Traxes/dimplex-zl400-esphome/docs/bilder/gehaeuse_oben.jpg

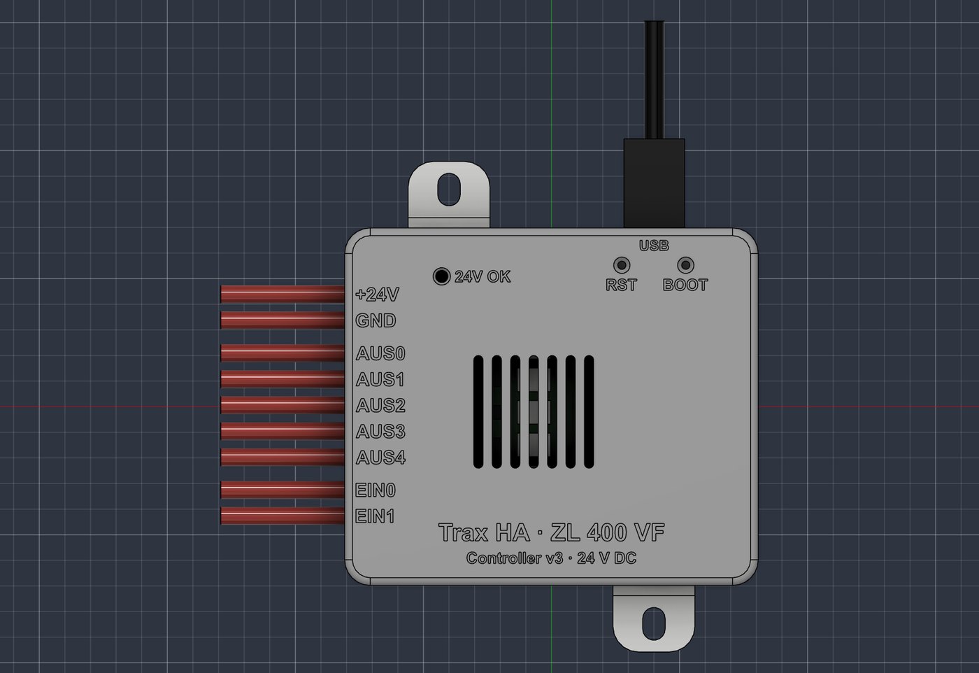
docs/bilder/gehaeuse_oben.jpg
