Traxes/dimplex-zl400-esphome/docs/bilder/massblatt_controller_v3.png

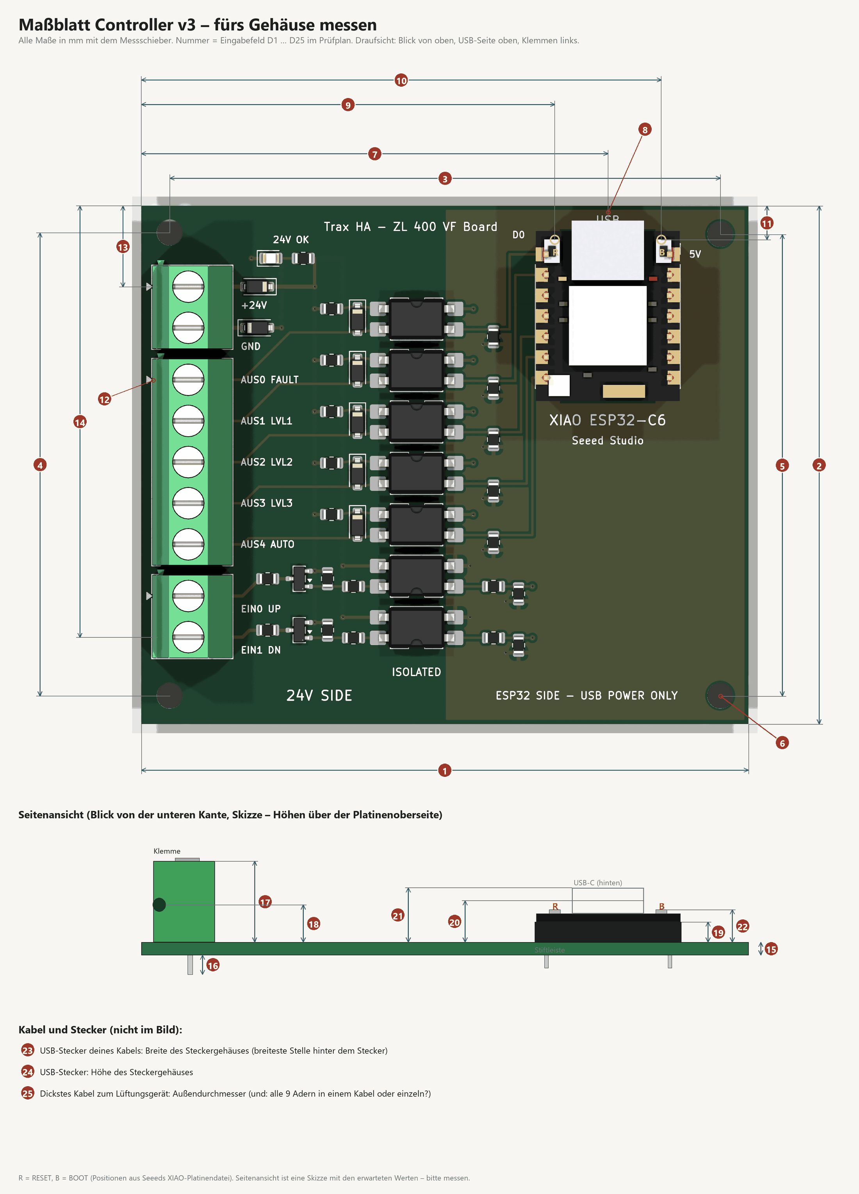
docs/bilder/massblatt_controller_v3.png
