Traxes/dimplex-zl400-esphome/hardware/controller-v3/fertigung-jlcpcb/BOM-ESP24V_HA_XIAO.csv

Comment | Designator | Footprint | LCSC Part #
1N4148W | D1,D2,D3,D4,D5,D7,D8 | Diode_SMD:D_SOD-123 | C81598
GREEN | D6 | LED_SMD:LED_0805_2012Metric | C2297
MMBT3906 | Q1,Q2 | Package_TO_SOT_SMD:SOT-23 | C2143
10k | R1,R2,R3,R4,R5,R6,R7,R8,R9,R10,R15,R16,R18,R19 | Resistor_SMD:R_0805_2012Metric | C17414
330 | R11,R12 | Resistor_SMD:R_0805_2012Metric | C17630
22k | R13,R14,R17 | Resistor_SMD:R_0805_2012Metric | C17560
1k | R20,R21 | Resistor_SMD:R_0805_2012Metric | C17513
EL817S | U1,U2,U3,U4,U5,U6,U7 | Package_DIP:SMDIP-4_W9.53mm | C63268
