Traxes/dimplex-zl400-esphome/hardware/emulator-lab-v2/fertigung-jlcpcb/BOM-ESP24V_Ventilation_LAB.csv

Comment | Designator | Footprint | LCSC Part #
GREEN | D1,D2,D3,D4,D5 | LED_SMD:LED_0805_2012Metric | C2297
RED | D6,D7 | LED_SMD:LED_0805_2012Metric | C84256
2.2k | R1,R2,R3,R4,R5 | Resistor_SMD:R_0805_2012Metric | C17520
10k | R6,R7,R8,R9,R10,R11,R12 | Resistor_SMD:R_0805_2012Metric | C17414
