Traxes/dimplex-zl400-esphome/gehaeuse/CentralVentilationCase_Baugruppe.step

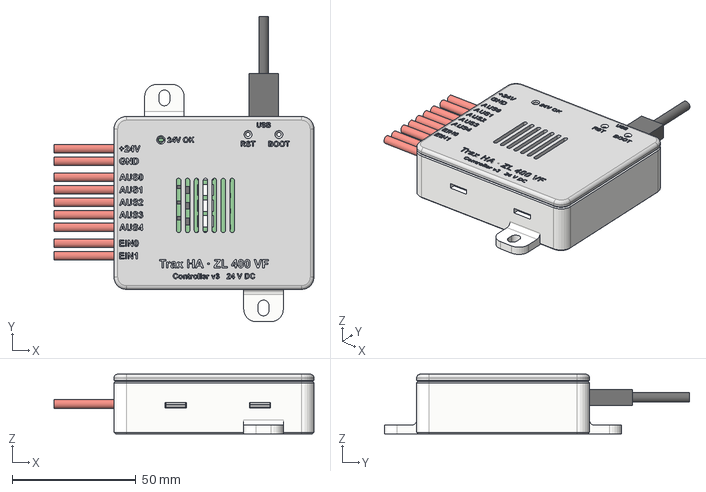
[picture p13: CAD file, 2026-10-19]
gehaeuse/CentralVentilationCase_Baugruppe.step
104.9 x 123.2 x 24.1 mm
