Traxes/dimplex-zl400-esphome/gehaeuse/CentralVentilationCase_BambuStudio_P2S_PLA.3mf

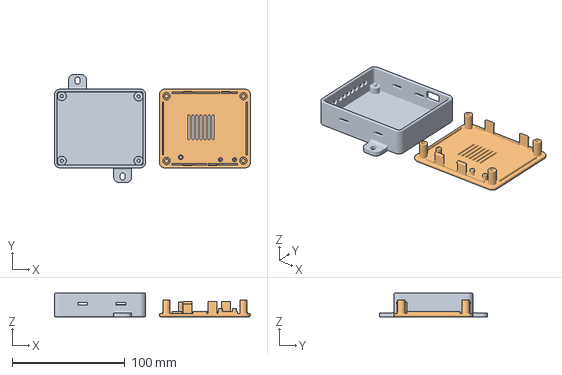
[picture p14: CAD file, 2026-10-19]
gehaeuse/CentralVentilationCase_BambuStudio_P2S_PLA.3mf
173.5 x 95.8 x 21.1 mm
Unterteil
Deckel
