Traxes/dimplex-zl400-esphome/gehaeuse/CentralVentilationCase_Deckel.stl

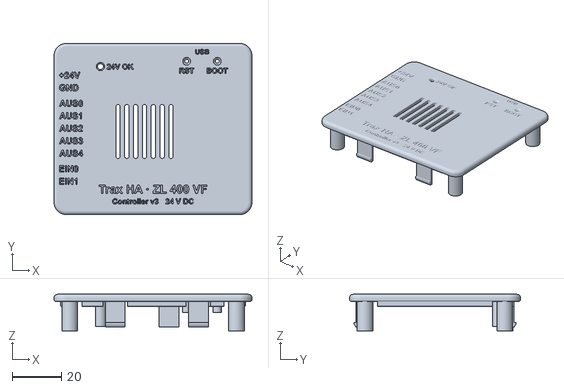
[picture p15: CAD file, 2026-10-19]
gehaeuse/CentralVentilationCase_Deckel.stl
80.7 x 69.8 x 14.9
