Traxes/dimplex-zl400-esphome/gehaeuse/CentralVentilationCase_Unterteil.stl

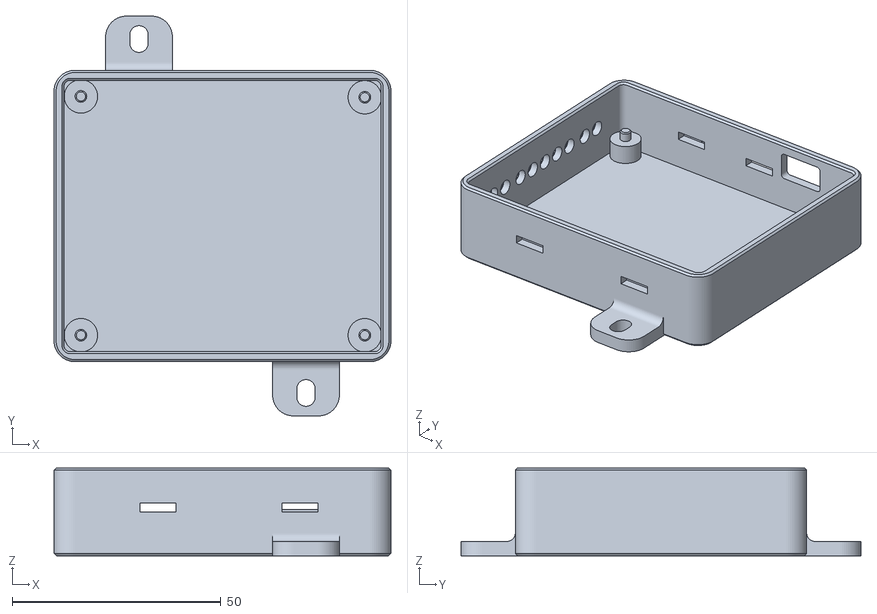
[picture p16: CAD file, 2026-10-19]
gehaeuse/CentralVentilationCase_Unterteil.stl
80.7 x 95.8 x 21.1
