Traxes/dimplex-zl400-esphome/(list of files, cad)

Other CAD files:
gehaeuse/CentralVentilationCase_Geometrie.3mf
