Traxes/dimplex-zl400-esphome/tools/verifikation/bringup_out.txt

== S0 alles aus (DIP offen, Ausgaenge LOW)
   v(rail)                   23.275 ..    23.425
   v(g24)                     0.575 ..     0.725
   I(J1) [mA]                 0.906 ..     0.919
   v(rail)-v(ina0)            0.000 ..     0.000
   v(rail)-v(ina1)            0.000 ..     0.000
   v(gp0)-v(eg)               0.001 ..     0.002
   v(gp1)-v(eg)               0.001 ..     0.002
   v(aus0)                   22.563 ..    22.935
   v(aus1)                   22.563 ..    22.935
   v(go0)-v(eg)              -0.000 ..     0.000
   v(go0)-v(oa0)             -0.000 ..     0.000
   v(ein0)                    0.990 ..     0.997
   v(rail)-v(cq0)            22.278 ..    22.435
   v(oc0)-v(g24)             22.547 ..    22.844
   v(ein1)                    0.990 ..     0.997
   v(rail)-v(bq1)             0.001 ..     0.002
   v(ol0)-v(eg)              -0.000 ..     0.000
== S1 AUS_0 aktiv + Ausgang HOCH an
   v(rail)                   23.161 ..    23.339
   v(g24)                     0.609 ..     0.770
   I(J1) [mA]                 5.583 ..     5.695
   v(rail)-v(ina0)           17.924 ..    18.281
   v(rail)-v(ina1)            0.000 ..     0.000
   v(gp0)-v(eg)               3.150 ..     3.263
   v(gp1)-v(eg)               0.001 ..     0.002
   v(aus0)                    3.921 ..     4.048
   v(aus1)                   22.453 ..    22.845
   v(go0)-v(eg)               2.971 ..     3.232
   v(go0)-v(oa0)              1.691 ..     2.096
   v(ein0)                   21.198 ..    21.395
   v(rail)-v(cq0)             0.019 ..     0.019
   v(oc0)-v(g24)              0.070 ..     0.097
   v(ein1)                    0.990 ..     0.997
   v(rail)-v(bq1)             0.001 ..     0.002
   v(ol0)-v(eg)               1.109 ..     1.312
== S2 alle 5 AUS aktiv, Ausgaenge LOW
   v(rail)                   23.122 ..    23.311
   v(g24)                     0.575 ..     0.725
   I(J1) [mA]                 9.832 ..    10.067
   v(rail)-v(ina0)           17.900 ..    18.253
   v(rail)-v(ina1)           17.900 ..    18.254
   v(gp0)-v(eg)               3.147 ..     3.263
   v(gp1)-v(eg)               3.147 ..     3.263
   v(aus0)                    3.915 ..     4.041
   v(aus1)                    3.915 ..     4.039
   v(go0)-v(eg)              -0.000 ..     0.000
   v(go0)-v(oa0)             -0.000 ..     0.000
   v(ein0)                    0.990 ..     0.996
   v(rail)-v(cq0)            22.126 ..    22.321
   v(oc0)-v(g24)             22.395 ..    22.730
   v(ein1)                    0.990 ..     0.996
   v(rail)-v(bq1)             0.001 ..     0.002
   v(ol0)-v(eg)              -0.000 ..     0.000
