Traxes/dimplex-zl400-esphome/hardware/controller-v3/Schaltplan_Controller_v3.pdf

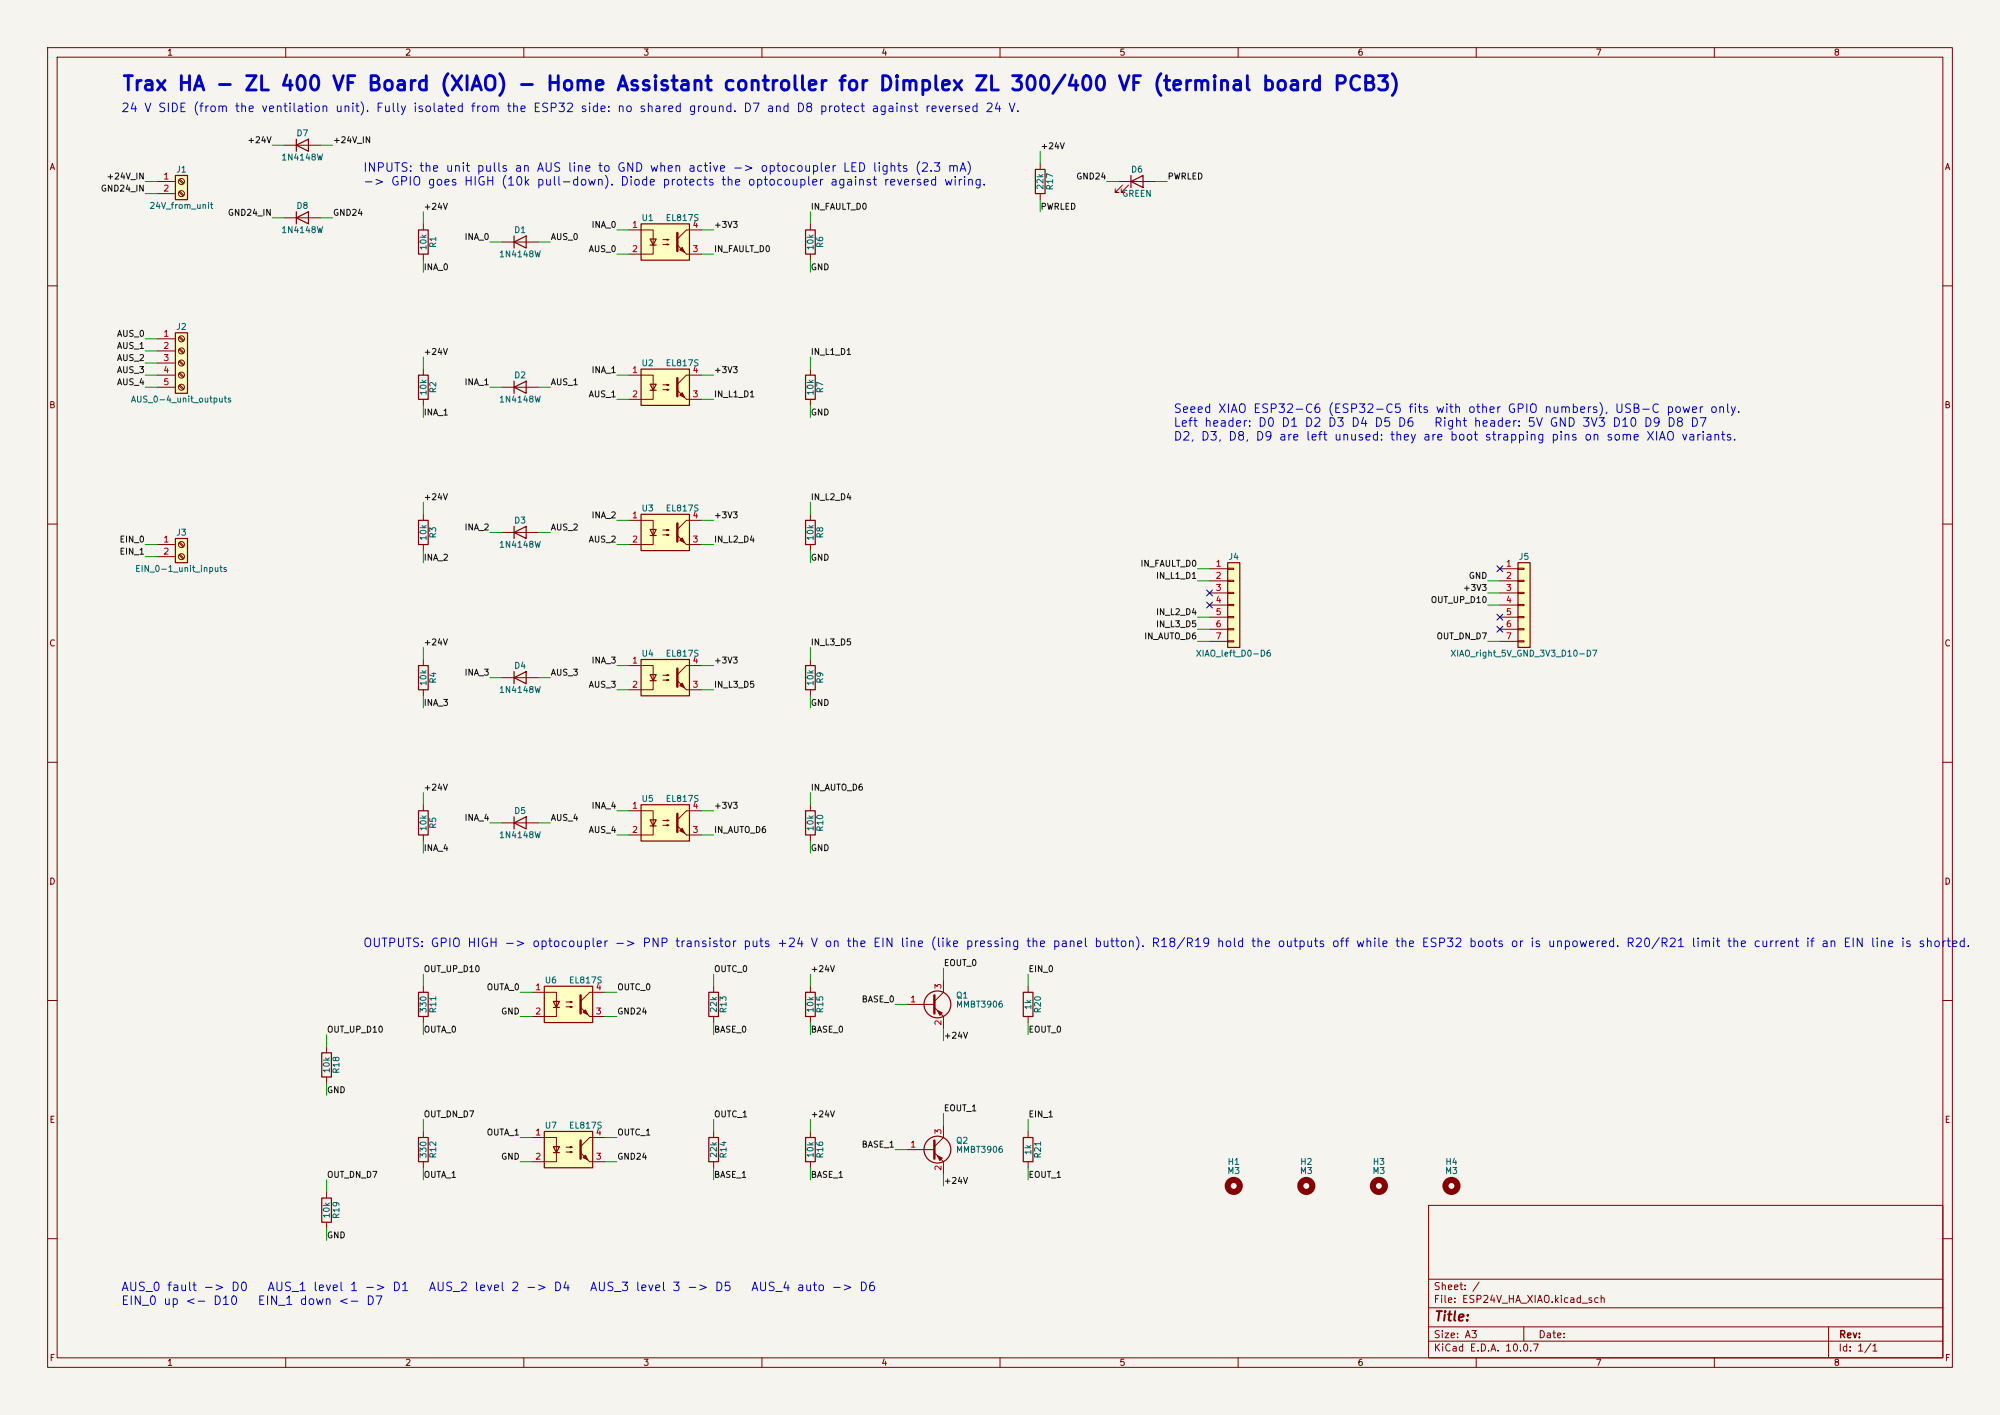
[picture p17: page 1]

Trax HA - ZL 400 VF Board (XIAO) - Home Assistant controller for Dimplex ZL 300/400 VF (terminal board PCB3)

24 V SIDE (from the ventilation unit). Fully isolated from the ESP32 side: no shared ground. D7 and D8 protect against reversed 24 V.

INA_0 +24V_IN
INPUTS: the unit pulls an AUS line to GND when active -> optocoupler LED lights (2.3 mA) -> GPIO goes HIGH (10k pull-down). Diode protects the optocoupler against reversed wiring.

Seeed XIAO ESP32-C6 (ESP32-C5 fits with other GPIO numbers), USB-C power only.
D2, D3, D8, D9 are left unused: they are boot strapping pins on some XIAO variants.

OUTPUTS: GPIO HIGH -> optocoupler -> PNP transistor puts +24 V on the EIN line (like pressing the panel button). R18/R19 hold the outputs off while the ESP32 boots or is unpowered. R20/R21 limit the current if an EIN line is shorted.

Size: A3 | Rev: | F Date:
KiCad E.D.A. 10.0.7 | Id: 1/1
