Traxes/dimplex-zl400-esphome/hardware/emulator-lab-v2/Schaltplan_Emulator_v2.pdf

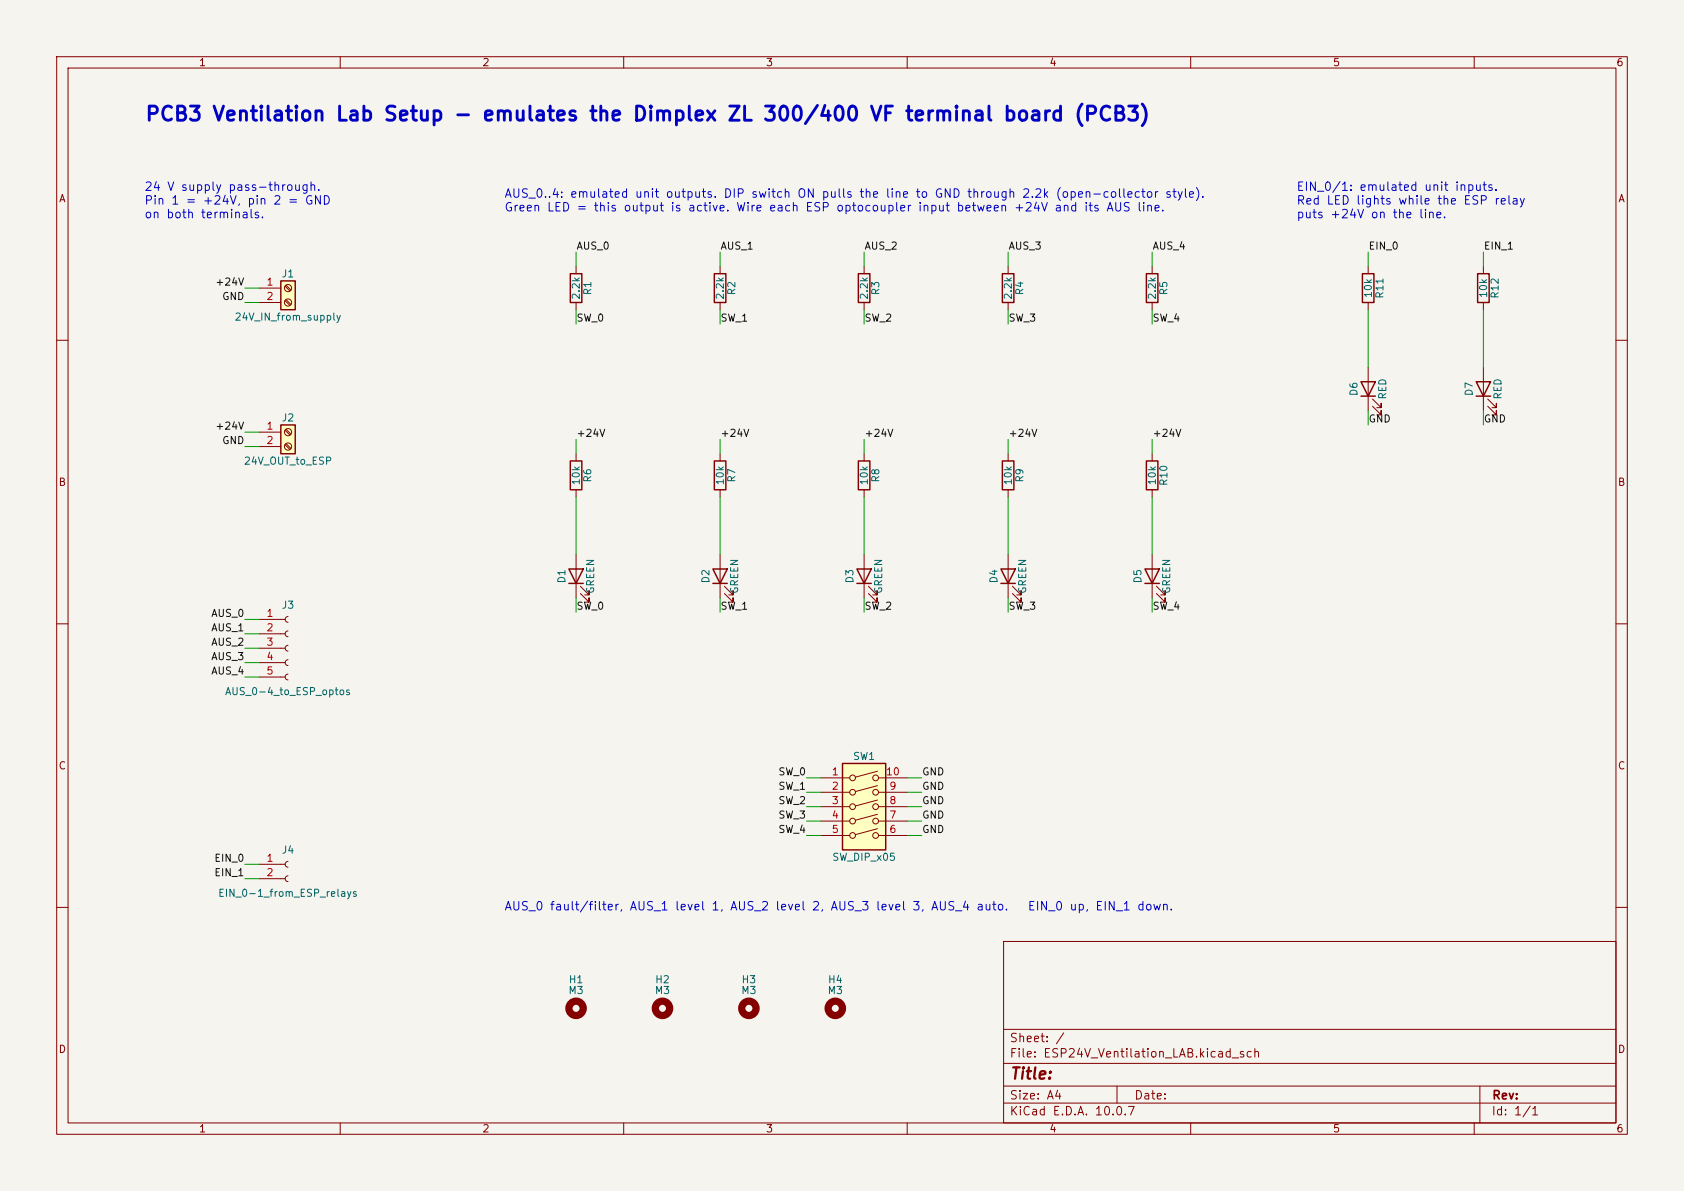
[picture p18: page 1]

PCB3 Ventilation Lab Setup - emulates the Dimplex ZL 300/400 VF terminal board (PCB3)

EIN_0/1: emulated unit inputs.
Red LED lights while the ESP relay
puts +24V on the line.

AUS_0..4: emulated unit outputs. DIP switch ON pulls the line to GND through 2.2k (open-collector style).
Green LED = this output is active. Wire each ESP optocoupler input between +24V and its AUS line.

Size: A4 | Rev:
KiCad E.D.A. 10.0.7 | Id: 1/1
