Traxes/dimplex-zl400-esphome/hardware/controller-v3/fertigung-jlcpcb/Bestueckungsplan_oben.pdf

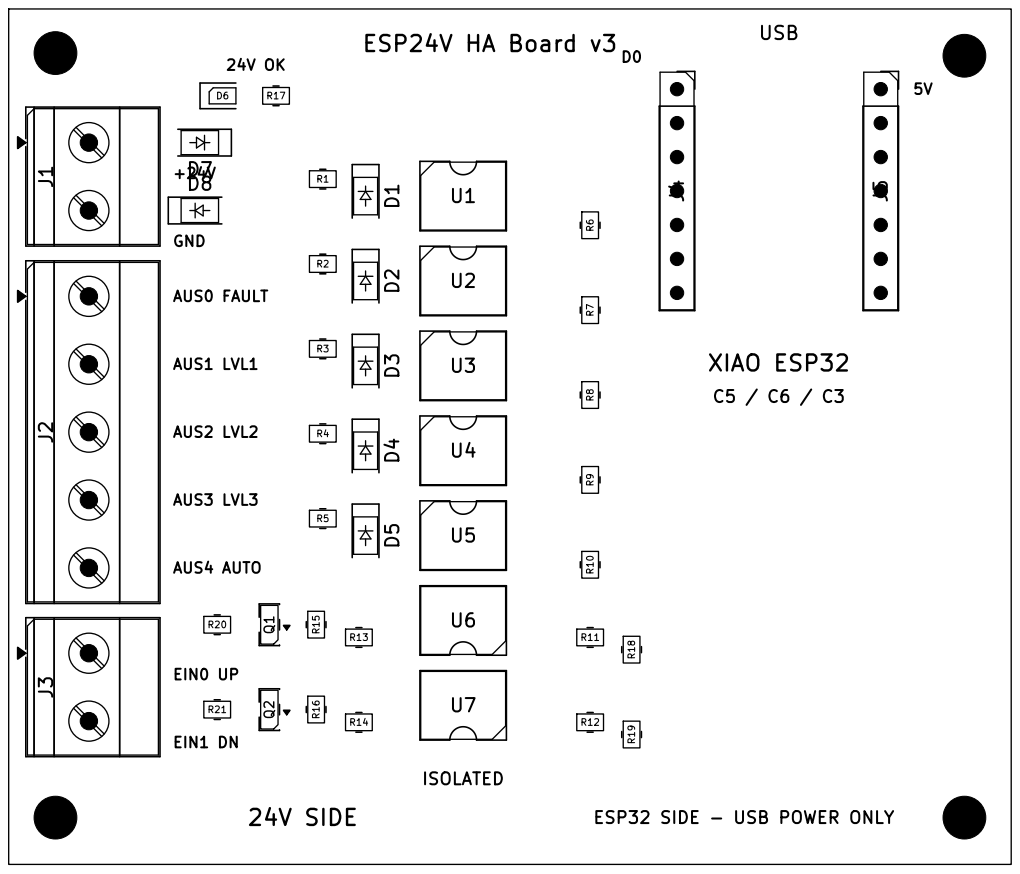
[picture p19: page 1]

ESP32 SIDE - USB POWER ONLY C5 / C6 / C3 USB 24V SIDE
