Traxes/dimplex-zl400-esphome/hardware/emulator-lab-v2/fertigung-jlcpcb/Bestueckungsplan_oben.pdf

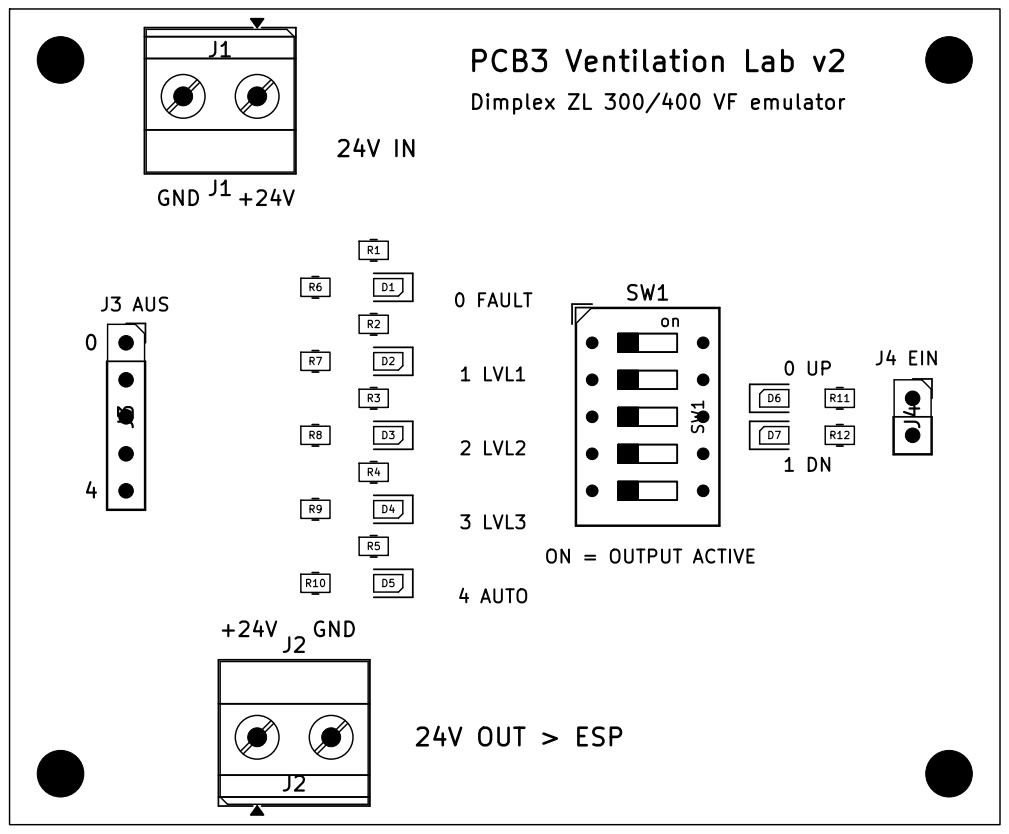
[picture p20: page 1]

24V OUT > ESP PCB3 Ventilation Lab v2

Dimplex ZL 300/400 VF emulator 24V IN
