Traxes/dimplex-zl400-esphome/hardware/emulator-lab-v2/kicad/ESP24V_Ventilation_LAB.kicad_pcb

## KiCad design hardware/emulator-lab-v2/kicad/ESP24V_Ventilation_LAB.kicad_pcb (2026-10-19)

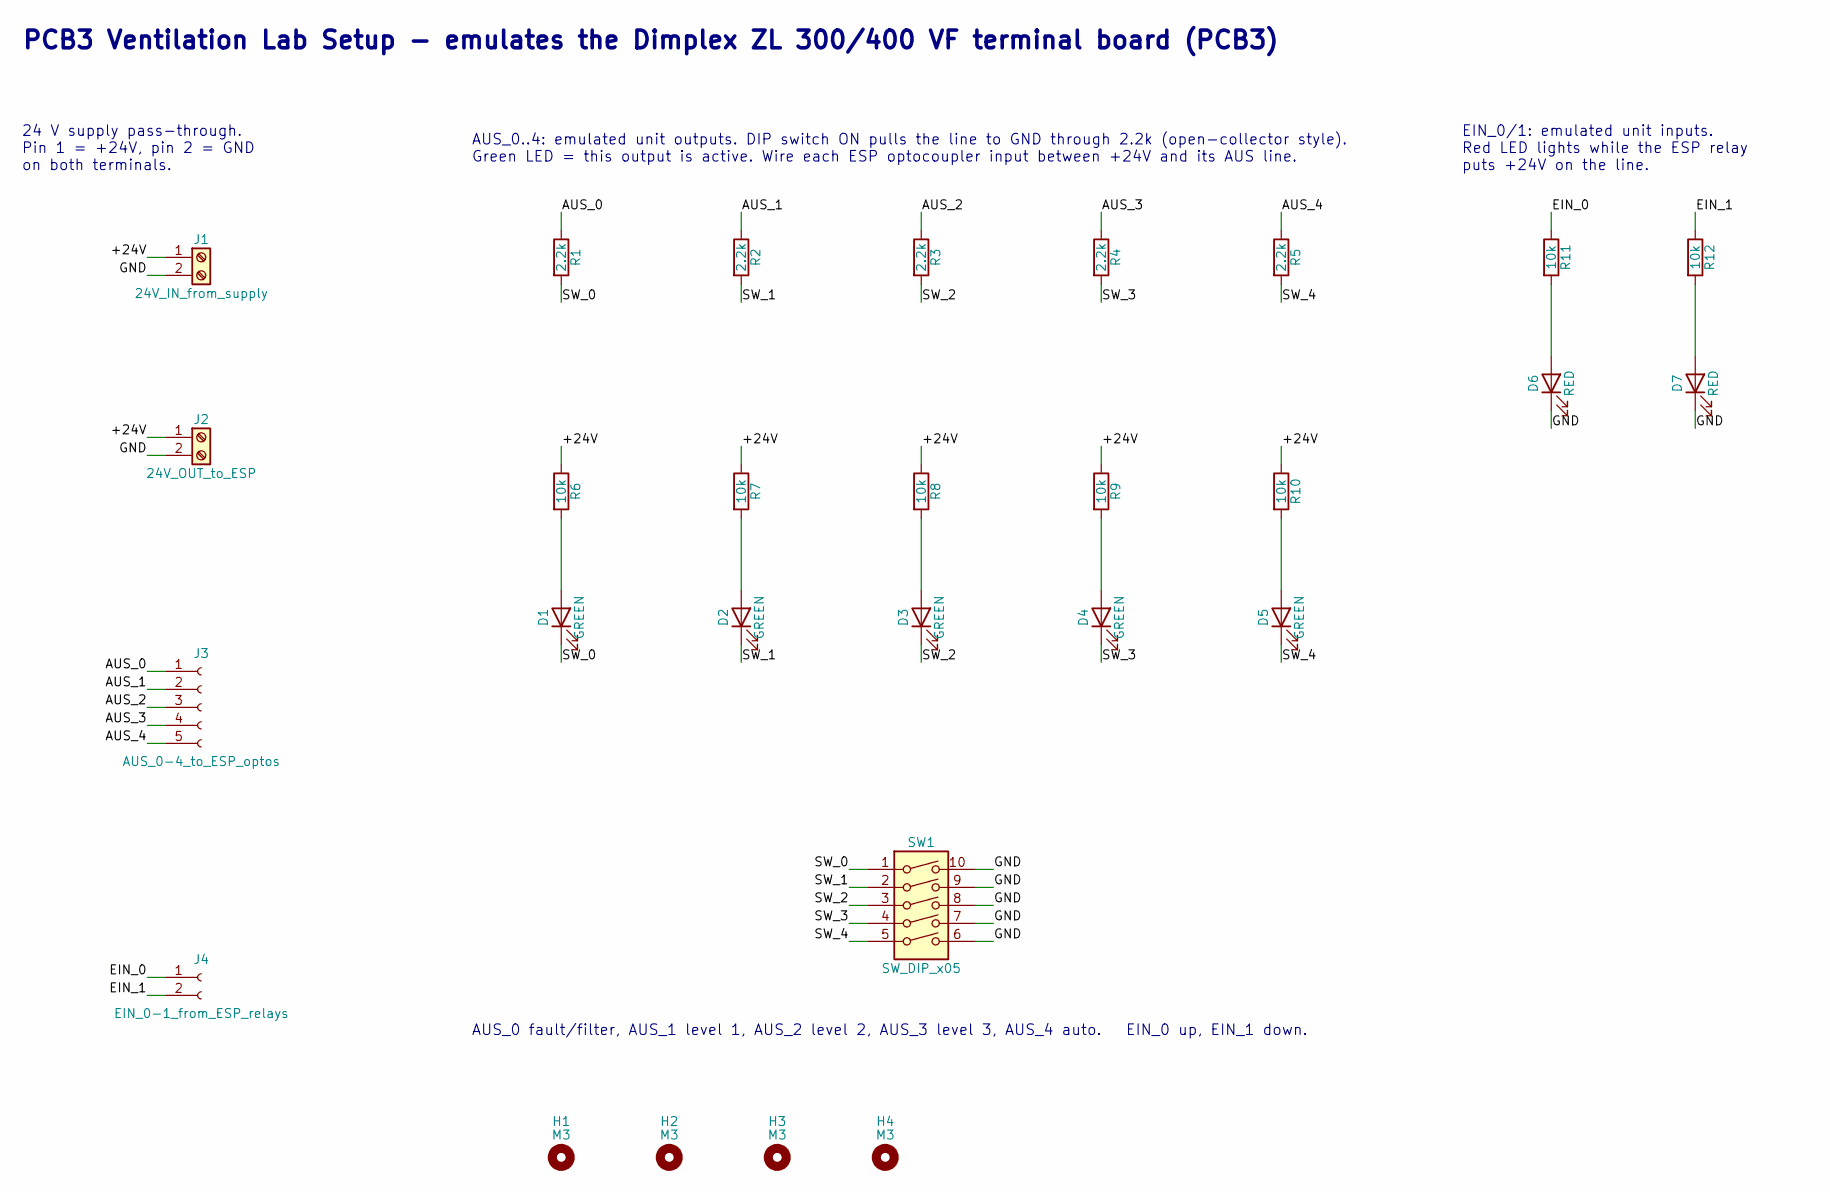
[picture p21: schematic ESP24V_Ventilation_LAB.kicad_sch]

Parts:
D1, D2, D3, D4, D5: GREEN; LED_0805_2012Metric; LCSC C2297
D6, D7: RED; LED_0805_2012Metric; LCSC C84256
H1, H2, H3, H4: M3; MountingHole_3.2mm_M3
J1: 24V_IN_from_supply; TerminalBlock_Phoenix_MKDS-1,5-2-5.08_1x02_P5.08mm_Horizont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
J2: 24V_OUT_to_ESP; TerminalBlock_Phoenix_MKDS-1,5-2-5.08_1x02_P5.08mm_Horizont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
J3: AUS_0-4_to_ESP_optos; PinSocket_1x05_P2.54mm_Vertical
J4: EIN_0-1_from_ESP_relays; PinSocket_1x02_P2.54mm_Vertical
R1, R2, R3, R4, R5: 2.2k; R_0805_2012Metric; LCSC C17520
R6, R7, R8, R9, R10, R11, R12: 10k; R_0805_2012Metric; LCSC C17414
SW1: SW_DIP_x05; SW_DIP_SPSTx05_Slide_9.78x14.88mm_W7.62mm_P2.54mm

Connections:
/+24V: J1.1, J2.1, R6.1, R7.1, R8.1, R9.1, R10.1
/AUS_0: J3.1, R1.1
/AUS_1: J3.2, R2.1
/AUS_2: J3.3, R3.1
/AUS_3: J3.4, R4.1
/AUS_4: J3.5, R5.1
/EIN_0: J4.1, R11.1
/EIN_1: J4.2, R12.1
/GND: D6.1 (K), D7.1 (K), J1.2, J2.2, SW1.6, SW1.7, SW1.8, SW1.9, SW1.10
/SW_0: D1.1 (K), R1.2, SW1.1
/SW_1: D2.1 (K), R2.2, SW1.2
/SW_2: D3.1 (K), R3.2, SW1.3
/SW_3: D4.1 (K), R4.2, SW1.4
/SW_4: D5.1 (K), R5.2, SW1.5
unnamed: D1.2 (A), R6.2
unnamed: D2.2 (A), R7.2
unnamed: D3.2 (A), R8.2
unnamed: D4.2 (A), R9.2
unnamed: D5.2 (A), R10.2
unnamed: D6.2 (A), R11.2
unnamed: D7.2 (A), R12.2

Notes on the sheet:
PCB3 Ventilation Lab Setup - emulates the Dimplex ZL 300/400 VF terminal board (PCB3)
AUS_0..4: emulated unit outputs. DIP switch ON pulls the line to GND through 2.2k (open-collector style). Green LED = this output is active. Wire each ESP optocoupler input between +24V and its AUS line.
EIN_0/1: emulated unit inputs. Red LED lights while the ESP relay puts +24V on the line.
AUS_0 fault/filter, AUS_1 level 1, AUS_2 level 2, AUS_3 level 3, AUS_4 auto. EIN_0 up, EIN_1 down.
24 V supply pass-through. Pin 1 = +24V, pin 2 = GND on both terminals.

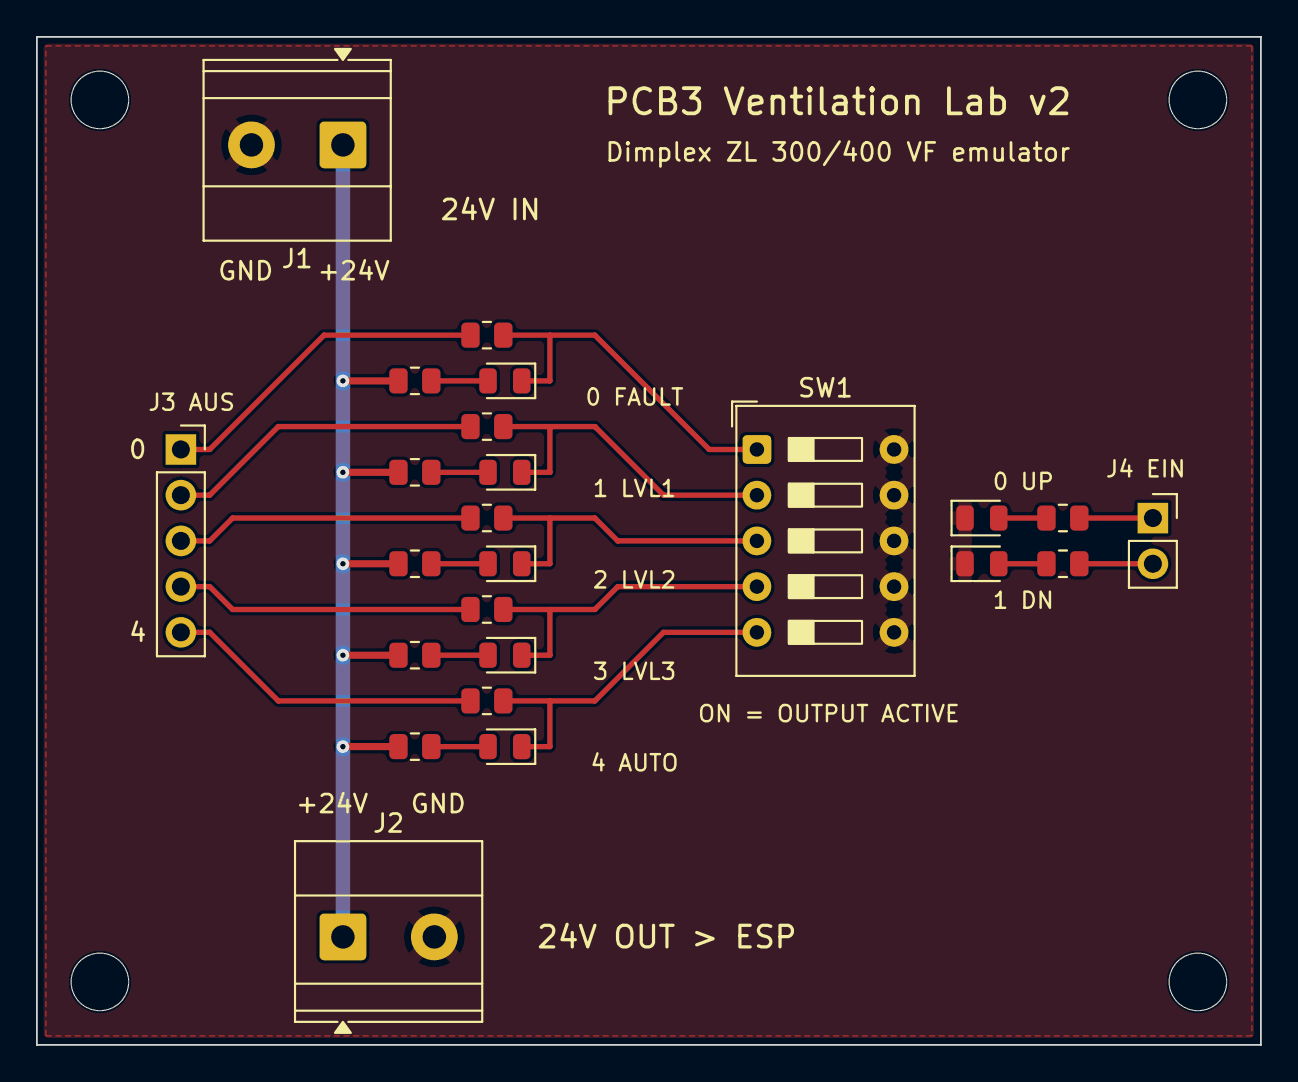
[picture p22: board ESP24V_Ventilation_LAB.kicad_pcb from above]

Board: 2 copper layers, 68.0 x 56.0 mm, 28 parts (0 on the bottom side), 21 nets.
