Traxes/dimplex-zl400-esphome/hardware/controller-v3/kicad/ESP24V_HA_XIAO.kicad_pcb

## KiCad design hardware/controller-v3/kicad/ESP24V_HA_XIAO.kicad_pcb (2026-10-19)

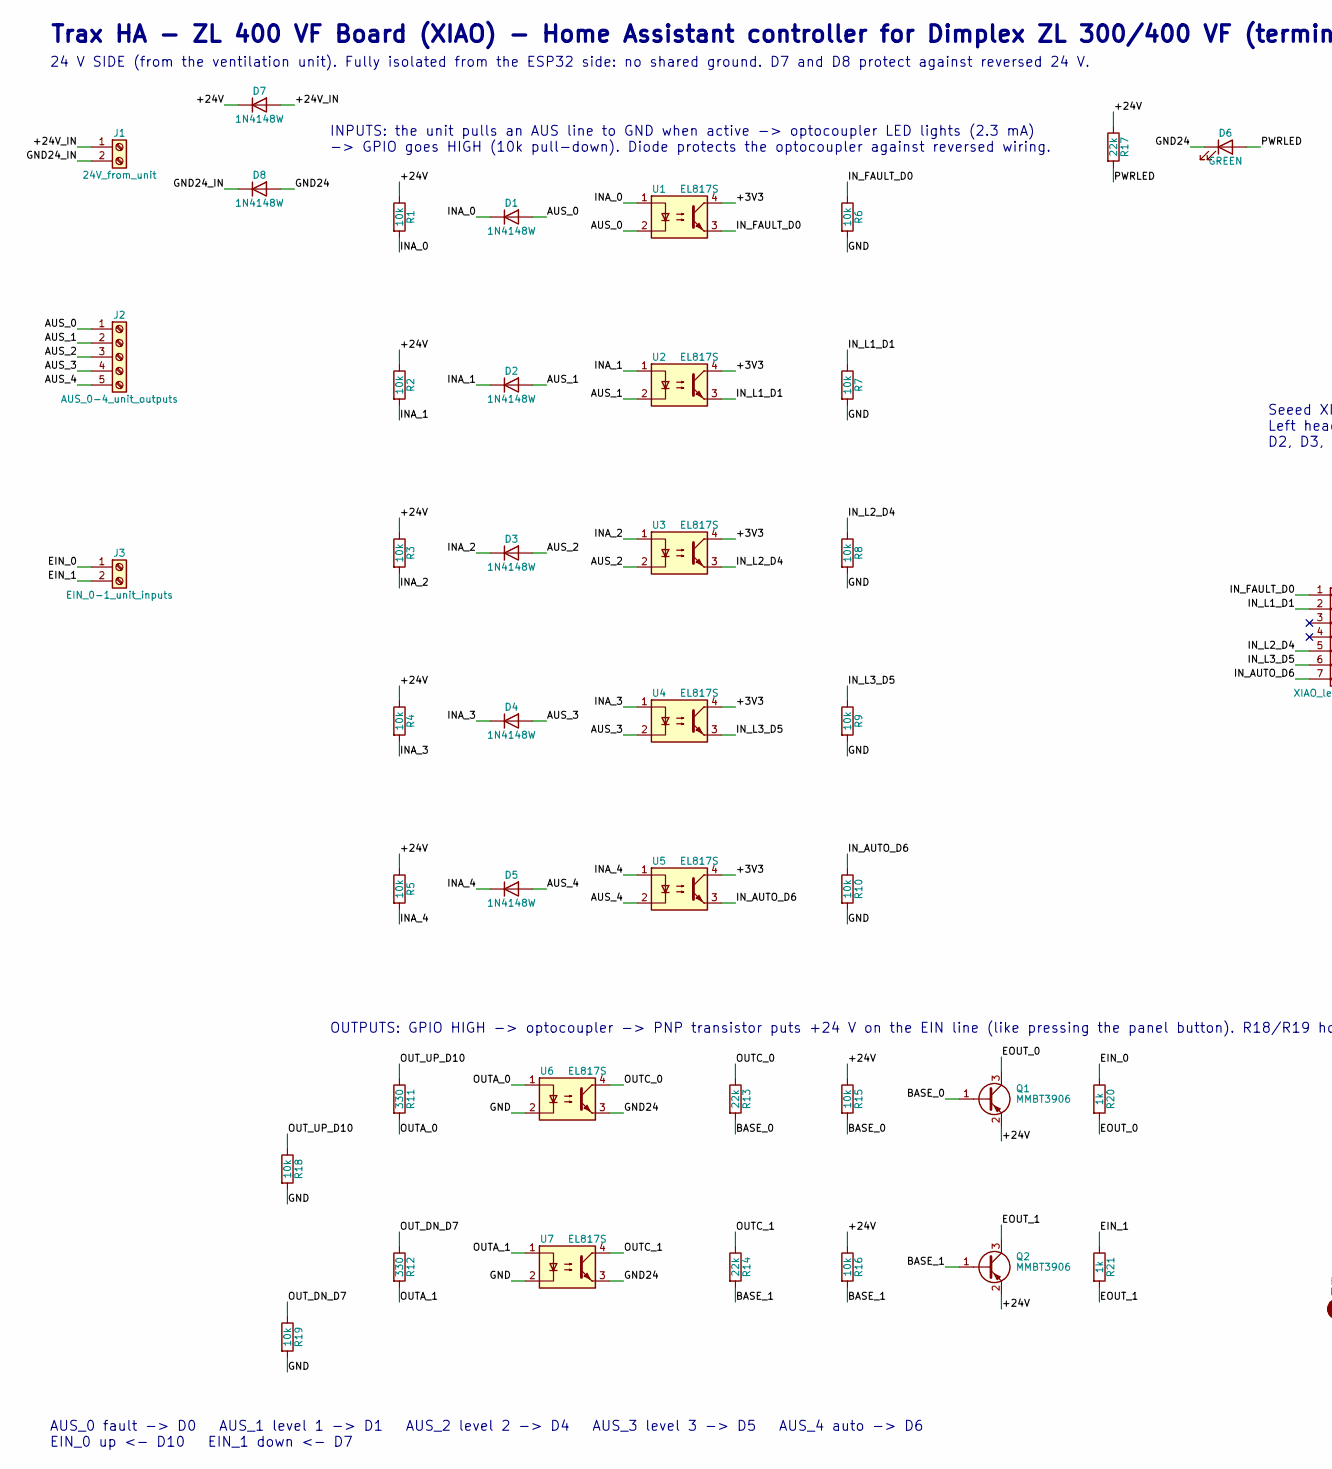
[picture p23: schematic ESP24V_HA_XIAO.kicad_sch, part in row 1, column 1]

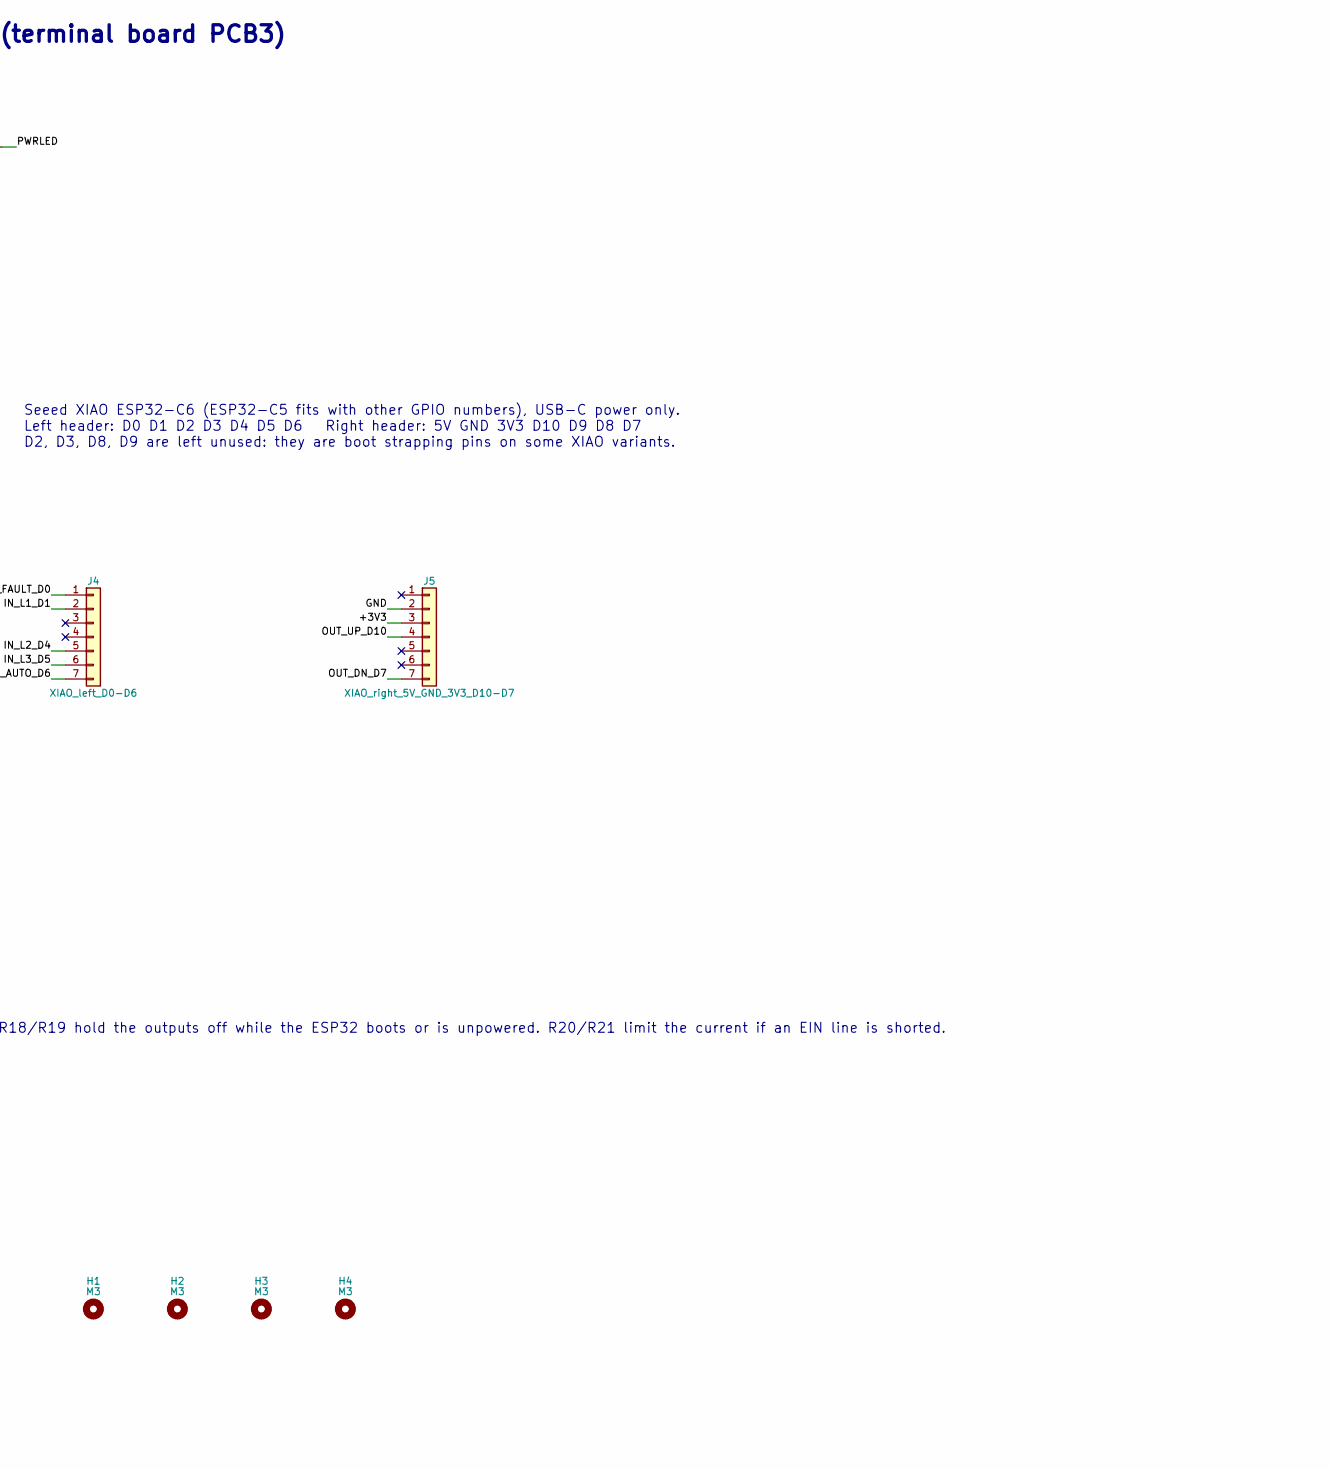
[picture p24: schematic ESP24V_HA_XIAO.kicad_sch, part in row 1, column 2]

Parts:
D1, D2, D3, D4, D5, D7, D8: 1N4148W; D_SOD-123; LCSC C81598
D6: GREEN; LED_0805_2012Metric; LCSC C2297
H1, H2, H3, H4: M3; MountingHole_3.2mm_M3
J1: 24V_from_unit; TerminalBlock_Phoenix_MKDS-1,5-2-5.08_1x02_P5.08mm_Horizont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
J2: AUS_0-4_unit_outputs; TerminalBlock_Phoenix_MKDS-1,5-5-5.08_1x05_P5.08mm_Horizont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
J3: EIN_0-1_unit_inputs; TerminalBlock_Phoenix_MKDS-1,5-2-5.08_1x02_P5.08mm_Horizont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
J4: XIAO_left_D0-D6; PinSocket_1x07_P2.54mm_Vertical
J5: XIAO_right_5V_GND_3V3_D10-D7; PinSocket_1x07_P2.54mm_Vertical
Q1, Q2: MMBT3906; SOT-23; LCSC C2143
R1, R2, R3, R4, R5, R6, R7, R8, R9, R10, R15, R16, R18, R19: 10k; R_0805_2012Metric; LCSC C17414
R11, R12: 330; R_0805_2012Metric; LCSC C17630
R13, R14, R17: 22k; R_0805_2012Metric; LCSC C17560
R20, R21: 1k; R_0805_2012Metric; LCSC C17513
U1, U2, U3, U4, U5, U6, U7: EL817S; SMDIP-4_W9.53mm; LCSC C63268

Connections:
/+3V3: J5.3, U1.4, U2.4, U3.4, U4.4, U5.4
/+24V: D7.1 (K), Q1.2 (E), Q2.2 (E), R1.1, R2.1, R3.1, R4.1, R5.1, R15.1, R16.1, R17.1
/+24V_IN: D7.2 (A), J1.1
/AUS_0: D1.2 (A), J2.1, U1.2
/AUS_1: D2.2 (A), J2.2, U2.2
/AUS_2: D3.2 (A), J2.3, U3.2
/AUS_3: D4.2 (A), J2.4, U4.2
/AUS_4: D5.2 (A), J2.5, U5.2
/BASE_0: Q1.1 (B), R13.2, R15.2
/BASE_1: Q2.1 (B), R14.2, R16.2
/EIN_0: J3.1, R20.1
/EIN_1: J3.2, R21.1
/EOUT_0: Q1.3 (C), R20.2
/EOUT_1: Q2.3 (C), R21.2
/GND: J5.2, R6.2, R7.2, R8.2, R9.2, R10.2, R18.2, R19.2, U6.2, U7.2
/GND24: D6.1 (K), D8.2 (A), U6.3, U7.3
/GND24_IN: D8.1 (K), J1.2
/INA_0: D1.1 (K), R1.2, U1.1
/INA_1: D2.1 (K), R2.2, U2.1
/INA_2: D3.1 (K), R3.2, U3.1
/INA_3: D4.1 (K), R4.2, U4.1
/INA_4: D5.1 (K), R5.2, U5.1
/IN_AUTO_D6: J4.7, R10.1, U5.3
/IN_FAULT_D0: J4.1, R6.1, U1.3
/IN_L1_D1: J4.2, R7.1, U2.3
/IN_L2_D4: J4.5, R8.1, U3.3
/IN_L3_D5: J4.6, R9.1, U4.3
/OUTA_0: R11.2, U6.1
/OUTA_1: R12.2, U7.1
/OUTC_0: R13.1, U6.4
/OUTC_1: R14.1, U7.4
/OUT_DN_D7: J5.7, R12.1, R19.1
/OUT_UP_D10: J5.4, R11.1, R18.1
/PWRLED: D6.2 (A), R17.2

Notes on the sheet:
Trax HA - ZL 400 VF Board (XIAO) - Home Assistant controller for Dimplex ZL 300/400 VF (terminal board PCB3)
24 V SIDE (from the ventilation unit). Fully isolated from the ESP32 side: no shared ground. D7 and D8 protect against reversed 24 V.
INPUTS: the unit pulls an AUS line to GND when active -> optocoupler LED lights (2.3 mA) -> GPIO goes HIGH (10k pull-down). Diode protects the optocoupler against reversed wiring.
OUTPUTS: GPIO HIGH -> optocoupler -> PNP transistor puts +24 V on the EIN line (like pressing the panel button). R18/R19 hold the outputs off while the ESP32 boots or is unpowered. R20/R21 limit the current if an EIN line is shorted.
Seeed XIAO ESP32-C6 (ESP32-C5 fits with other GPIO numbers), USB-C power only. Left header: D0 D1 D2 D3 D4 D5 D6 Right header: 5V GND 3V3 D10 D9 D8 D7 D2, D3, D8, D9 are left unused: they are boot strapping pins on some XIAO variants.
AUS_0 fault -> D0 AUS_1 level 1 -> D1 AUS_2 level 2 -> D4 AUS_3 level 3 -> D5 AUS_4 auto -> D6 EIN_0 up <- D10 EIN_1 down <- D7

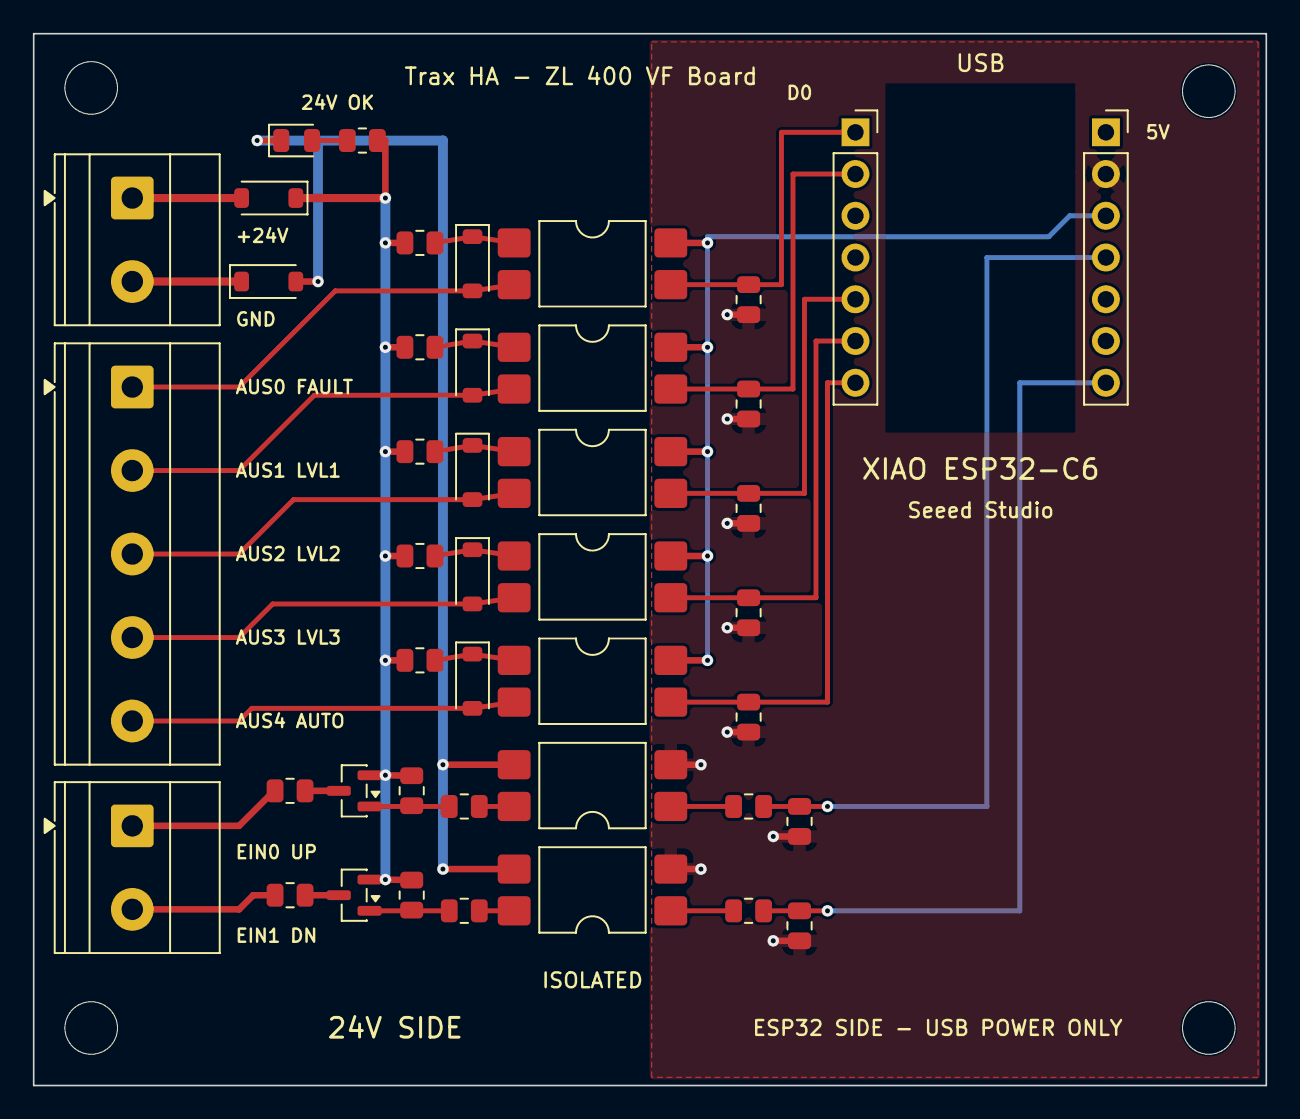
[picture p25: board ESP24V_HA_XIAO.kicad_pcb from above]

Board: 2 copper layers, 75.0 x 64.0 mm, 47 parts (0 on the bottom side), 34 nets.
