Traxes/dimplex-zl400-esphome/(commit log)

2026-10-19 Initial import: controller v3, ESPHome firmware, enclosure, docs
    - KiCad project and JLCPCB fabrication files for controller v3 and the PCB3 emulator
    - ESPHome configuration for the XIAO ESP32-C6 (secrets via secrets.yaml only)
    - Snap-fit enclosure: STL/3MF/STEP, Bambu Studio project, Fusion 360 script
    - QA reports, commissioning checklist, wiring and block diagrams
    - README in English and German
    [BOM-ESP24V_HA_XIAO.csv, BOM-ESP24V_Ventilation_LAB.csv, CentralVentilationCase_BambuStudio_P2S_PLA.3mf, CentralVentilationCase_Baugruppe.step, CentralVentilationCase_Deckel.stl, CentralVentilationCase_Geometrie.3mf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]
2026-10-19 Add photos of the installed controller and a build-on-request offer
    - Two photos (metadata-free JPEG): installed on a ZL 400 VF, board in the printed case
    - Offer at the top of both READMEs to build PCB + enclosure on request, any color,
    via a prefilled GitHub issue (no personal data in issues)
    - Image galleries rearranged
2026-10-19 Add detailed safety notes (EN/DE)
    Mains disconnection, 24 V control circuit only, wiring checks and ferrules,
    RM smoke-detector bridge, unit transformer load, USB isolation, enclosure
    flammability and location, minimum ventilation, combustion appliances,
    fallback and liability.
2026-10-19 Add Home Assistant screenshot, speed names and status texts
    - Device page screenshot (MAC address and firmware build line removed)
    - Fan dialog speeds Off/Low/Medium/High, status sensor texts with meaning
    - Real command timeline from the activity log, tested ESPHome version
